jasonf27/Mechatronics_Grand_Theft_Autonomous/README.md

# Mechatronics: Grand Theft Autonomous

For a complete project description, please visit [my personal website](https://www.jason-friedman.me/projects/mechatronics).
