jasonf27/Mechatronics_Grand_Theft_Autonomous/Pics:Video/IMG_6468.jpeg

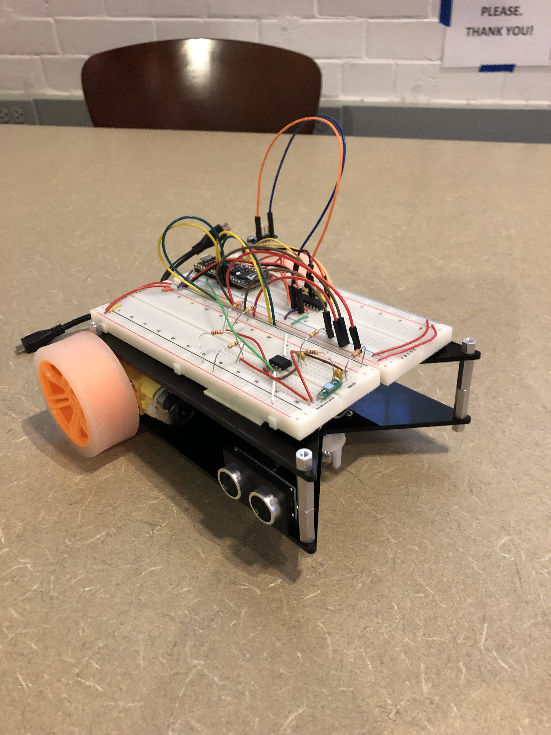
Pics:Video/IMG_6468.jpeg
