jasonf27/Mechatronics_Grand_Theft_Autonomous/Pics:Video/IMG_6474.jpeg

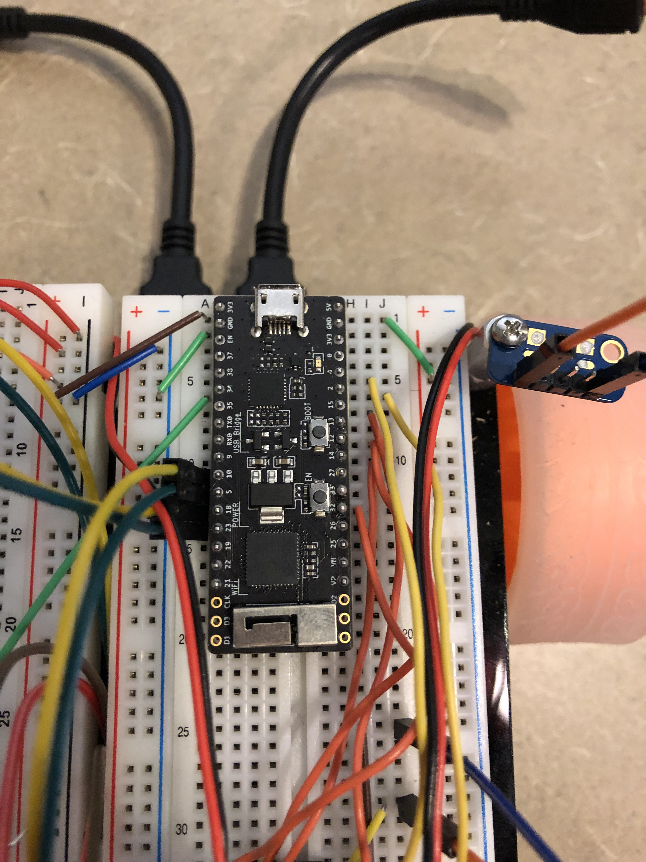
Pics:Video/IMG_6474.jpeg
