jasonf27/Mechatronics_Grand_Theft_Autonomous/Lab4.1.5/html510.h

/*
 * header for MEAM510 hacks for web interface
 * Dec 2021
 * 
 * Niko Simpkins (adapted from Mark Yim) 
 * University of Pennsylvania
 * copyright (c) 2021 All Rights Reserved
 */

#ifndef HTML510SERVER_h
#define HTML510SERVER_h

#include <WiFi.h>
#include <WiFiClient.h>
const char HTMLtext[] PROGMEM = R"===(HTTP/1.1 200 OK
Content-type:text/html

)==="; // note last newline is important  

const char plaintext[] PROGMEM = R"===(HTTP/1.1 200 OK
Content-type:text/plain

)==="; // note last newline is important  


class HTML510Server
{
private:
  WiFiClient client;
  WiFiServer server; 
  
  #define MAXHANDLERS 30
  int numHandler=0;
  void (*handlerptrs[MAXHANDLERS])();
  String handlerpars[MAXHANDLERS];
  
public:
  HTML510Server(int port): server(port) // default constructor
  {    
  }
  void begin(int port=80);
  void attachHandler(String key, void (*handler)());
  void serve();
  void sendhtml(String data) ;
  void sendplain(String data);
  String getText();
  int getVal();
};

#endif
